TheBurmaRaider/SkySkipper/SkySkipper PCB/27913384_10215366778827458_3721116622841293099_o.jpeg

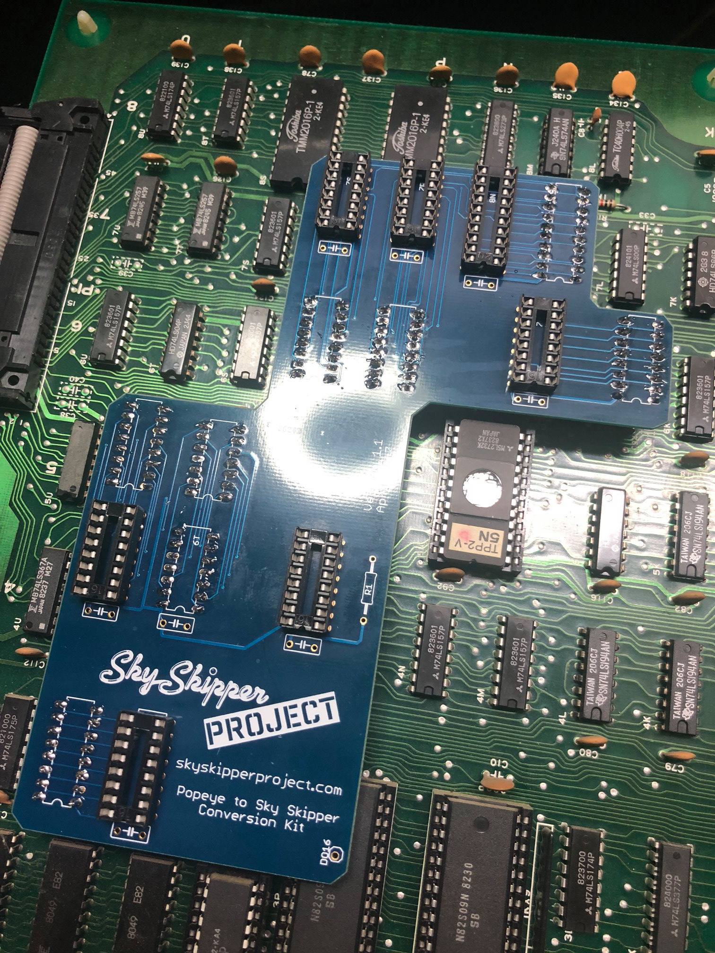
SkySkipper PCB/27913384_10215366778827458_3721116622841293099_o.jpeg
