TheBurmaRaider/SkySkipper/SkySkipper PCB/27798071_10215366779107465_7851663914407115662_o.jpg

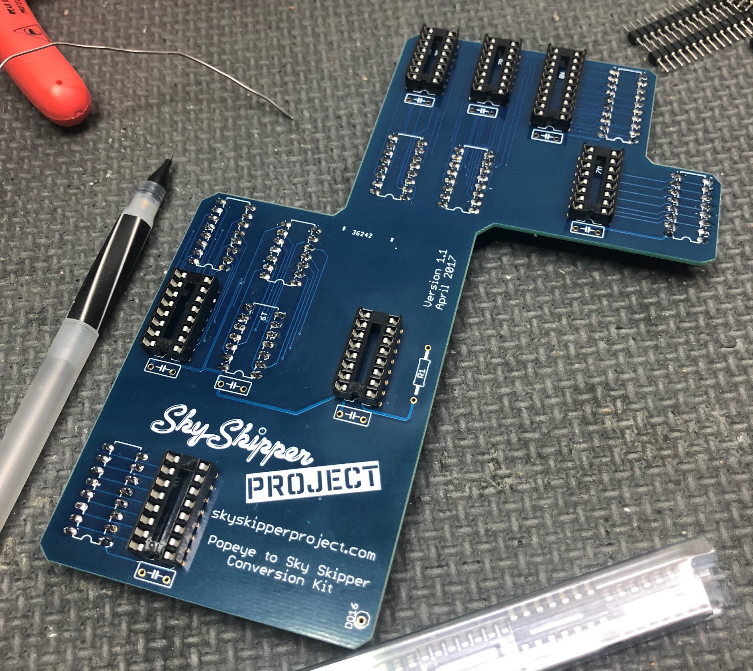
SkySkipper PCB/27798071_10215366779107465_7851663914407115662_o.jpg
