TheBurmaRaider/SkySkipper/README.md

Skipper should be available for all. 
PCBs that were given to those in the Skipper Program don't boot properly. Feel free to make your own and help solve.
