TheBurmaRaider/SkySkipper/SkySkipper PCB/28061451_10215366778147441_8789408564157505989_o.jpeg

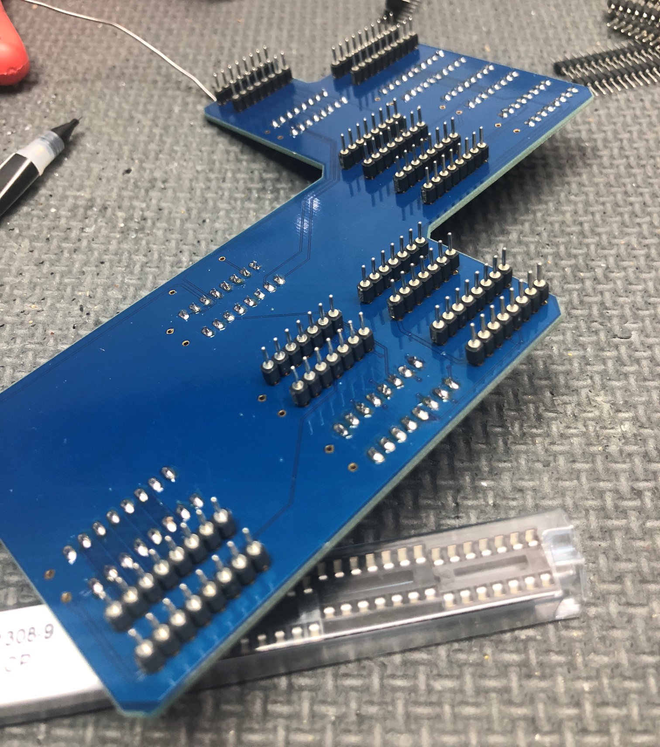
SkySkipper PCB/28061451_10215366778147441_8789408564157505989_o.jpeg
