TheBurmaRaider/SkySkipper/SkySkipper PCB/SSboard_01.jpeg

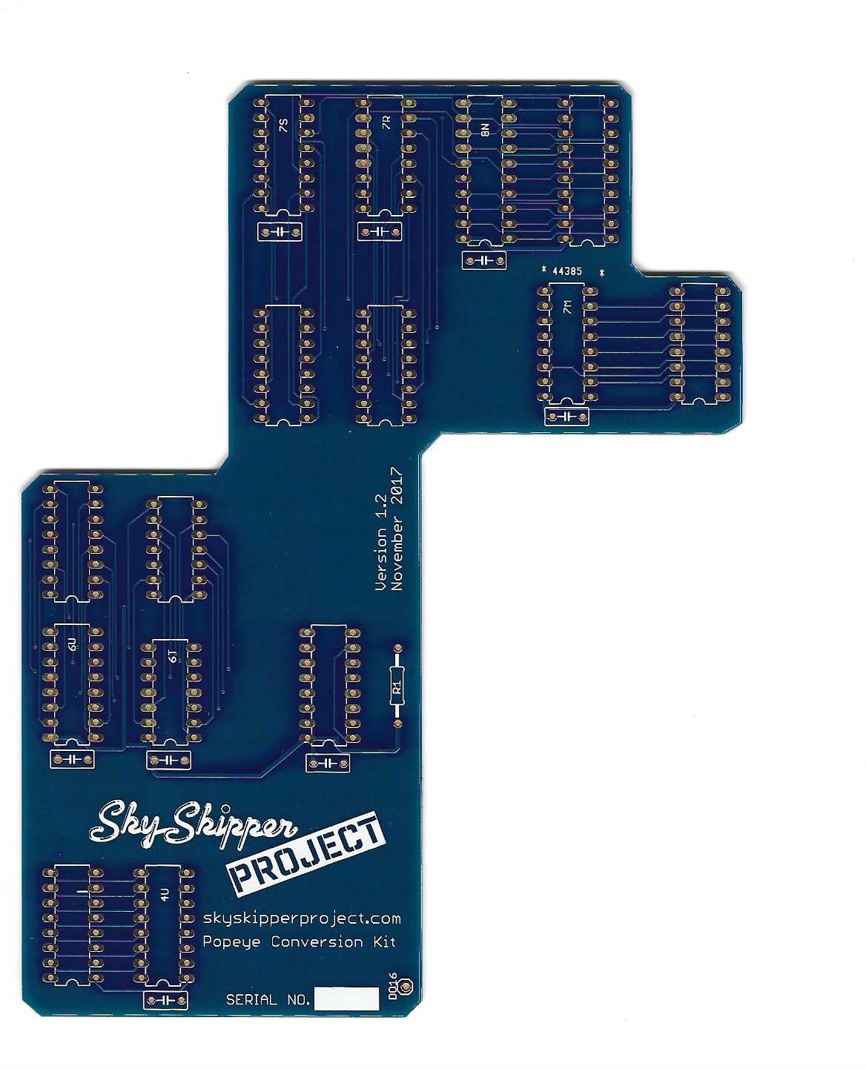
SkySkipper PCB/SSboard_01.jpeg
