TheBurmaRaider/SkySkipper/SkySkipper PCB/SSBoard_02.jpeg

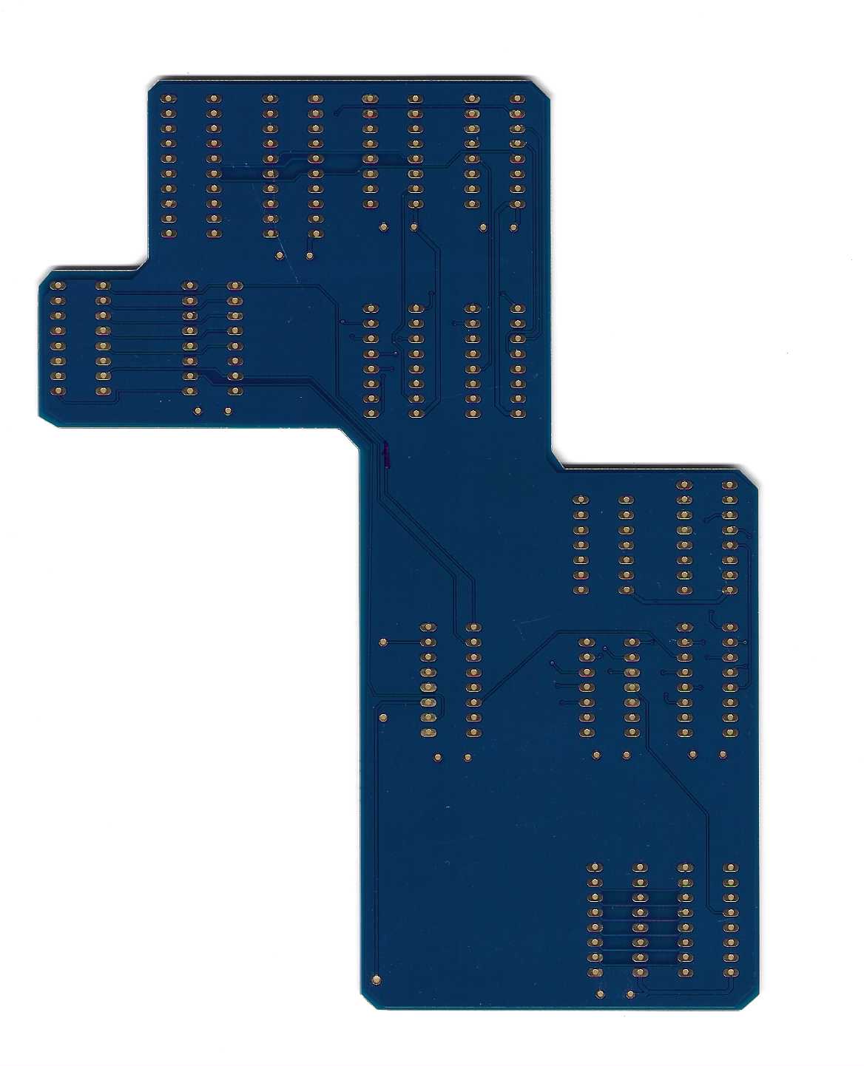
SkySkipper PCB/SSBoard_02.jpeg
