TheBurmaRaider/SkySkipper/SkySkipper PCB/New PCB test page.pdf

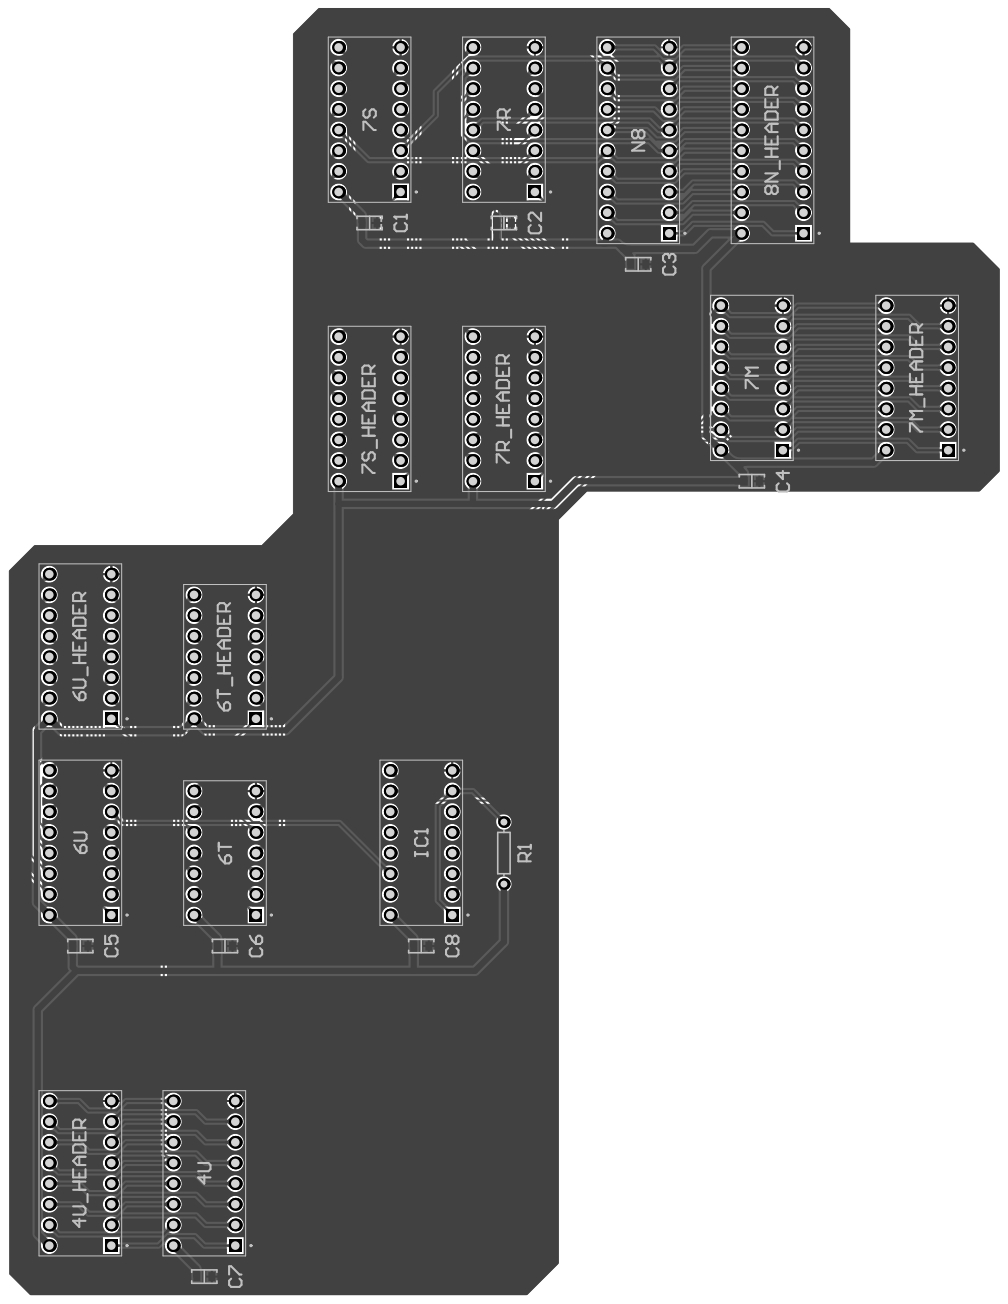
[picture p16: page 1]
