TheBurmaRaider/SkySkipper/SkySkipper PCB Repro/SkySkipper_Popeye.pdf

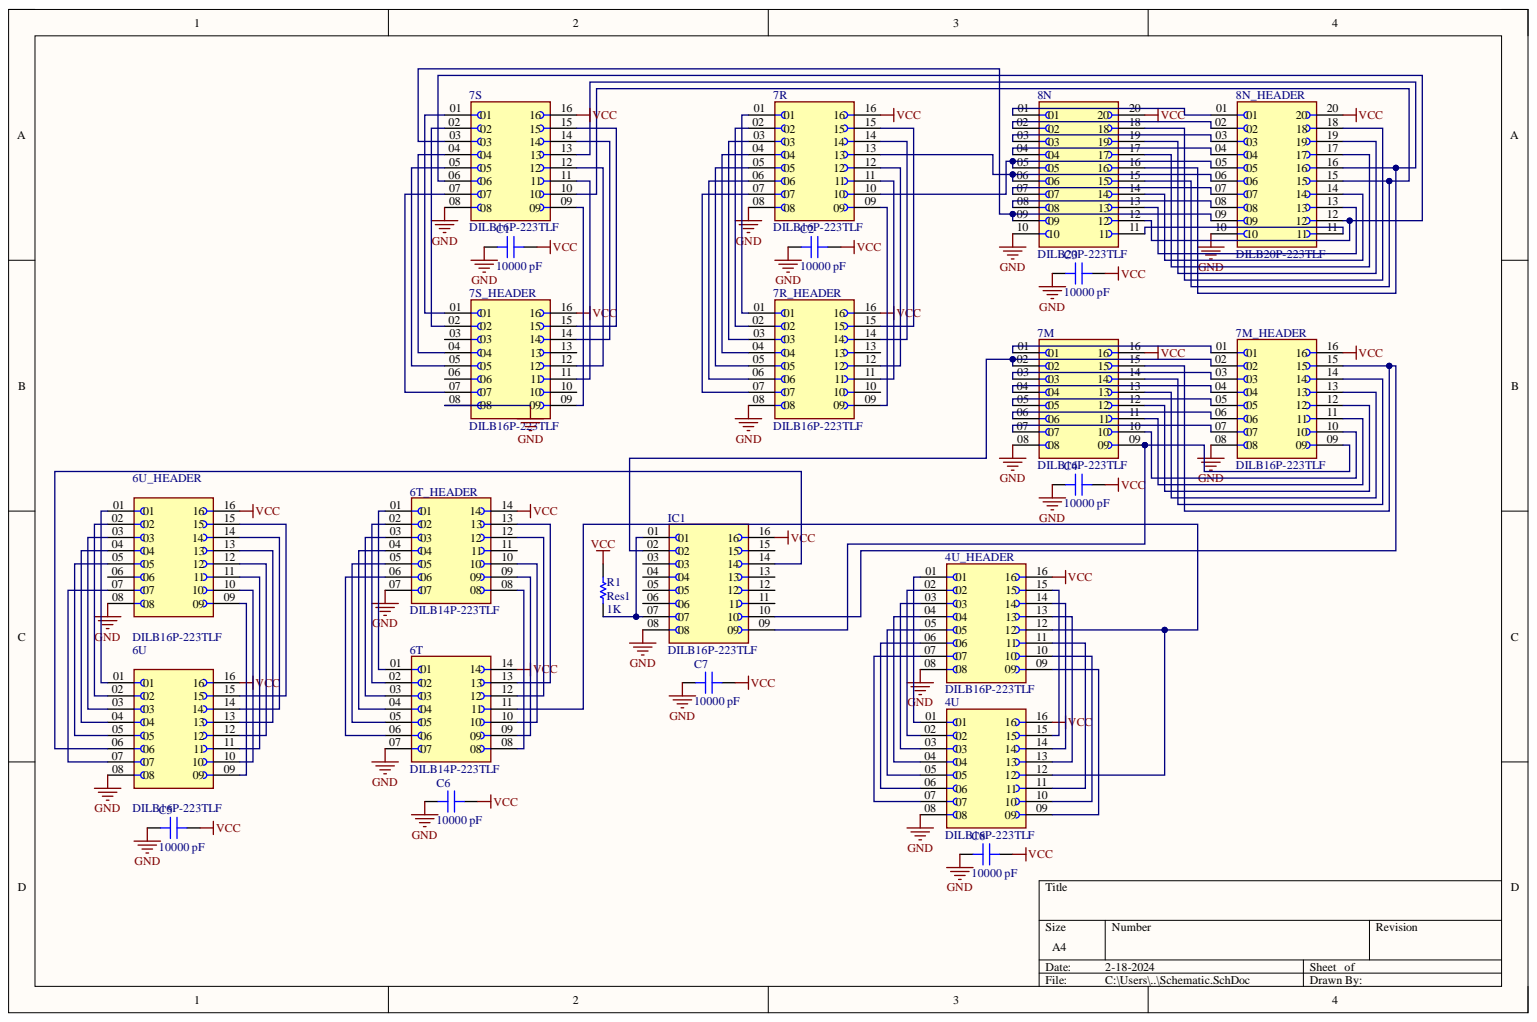
[picture p17: page 1]

03 03 19 | 19
04 04 17 | 17
05 05 16 | 16
06 06 15 | 15
07 07 14 | 14
08 08 13 | 13
09 09

01 01 16 | 16
02 02 15 | 15
03 03 14 | 14
04 04 13 | 13
05 05 12 | 12
06 06 11 | 11
07 07 10 | 10

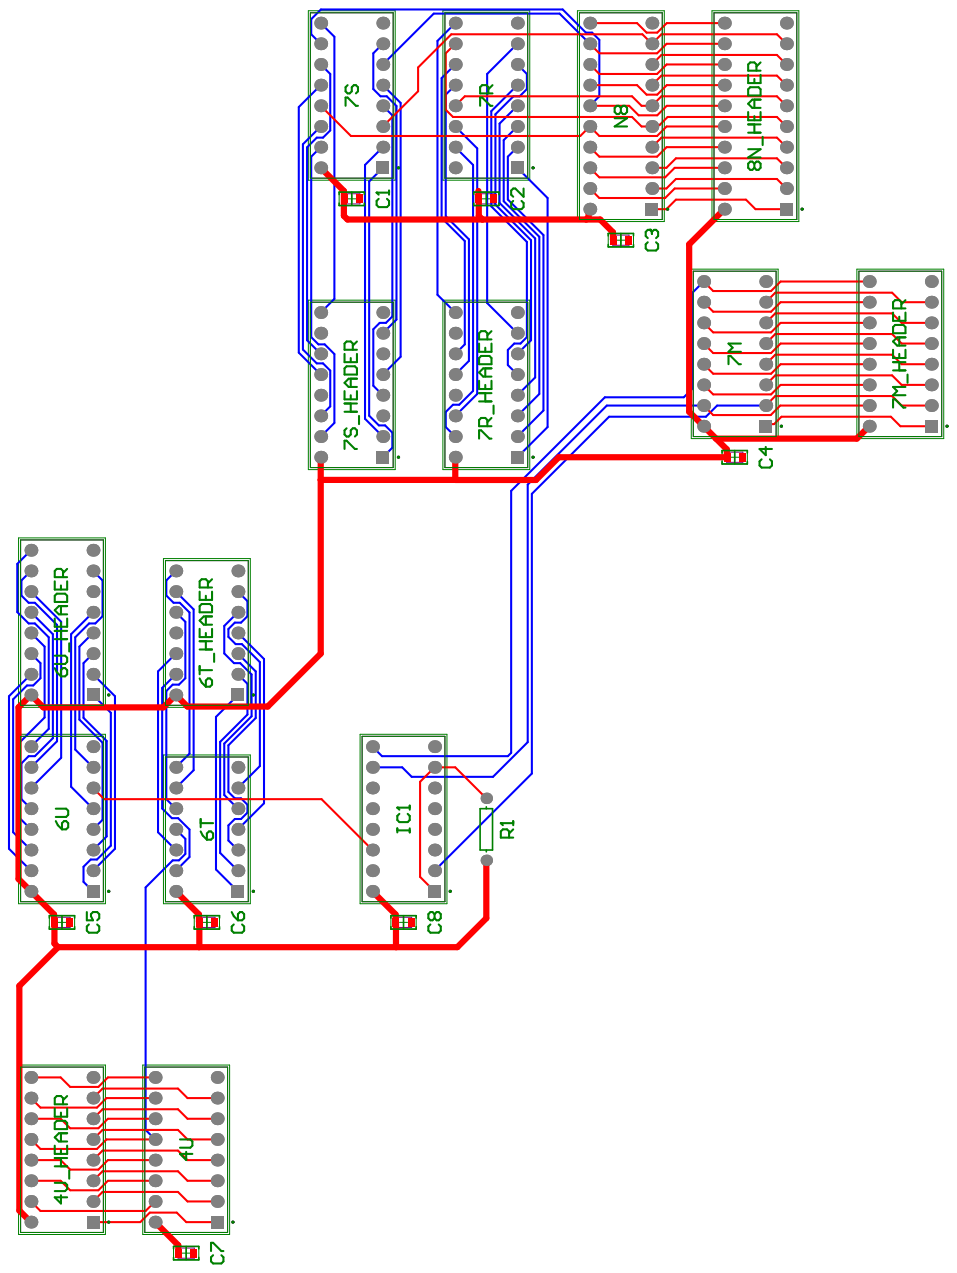
[picture p18: page 2]
