TheBurmaRaider/SkySkipper/(list of files, drawings)

Other design files:
SkySkipper PCB Repro/Schematic.SchDoc
SkySkipper PCB Repro/Skyskipper1.PcbDoc
SkySkipper PCB Repro/SkySkipper_Popeye.PrjPcb
